citizensense/dustbox/README.md

# Dustbox

A place to hold details of the [particulate matter sensor](http://www.citizensense.net/sensors/particulate-matter-prototype/).

## Contents

 * [Dustbox-BOM.xls](Dustbox-BOM.xls) - Bill of Materials (i.e. parts needed to build a Dustbox)
 * [Dustbox.kicad_mod](Dustbox.kicad_mod) - Custom KiCad footprints used by the board (initially just the Dustbox text)
 * [Dustbox.kicad_pcb](Dustbox.kicad_pcb) - KiCad PCB design file
 * [Dustbox.net](Dustbox.net) - KiCad netlist file
 * [Dustbox.pro](Dustbox.pro) - Main KiCad project file
 * [Dustbox.sch](Dustbox.sch) - KiCad schematic file
 * [README.md](README.md) - this file
