citizensense/dustbox/Dustbox-BOM.xls

Dustbox
Bill of Materials
Part | PCB Label | Quantity | Supplier | Part Number
Electric Imp | n/a | 1
April board | n/a | 1
Shinyei PPD42NS | n/a | 1
Fan | n/a | 1
2-way 2.54mm pitch screw terminal | P3 | 1 | Farnell | 2112482
3-way 2.54mm pitch screw terminal | P2 | 1 | Farnell | 2396254
560 ohm resistor | R1 | 1 | Farnell | 2329690
1k ohm resistor | R2 | 1 | Farnell | 2329626
2-way 2.54mm pitch header | P5 | 1 | Farnell | 3419046
9-way 2.54mm pitch header | P4 | 1
Optional battery power circuit
2-way 2.54mm pitch screw terminal | P1 | 1 | Farnell | 2112482
1N5817 schottkey diode | D1 | 1 | Farnell | 9801197
LF50CV 5V LDO regulator | U1 | 1 | Farnell | 1094240
