citizensense/dustbox/(commit log)

2016-08-26 Add initial version of the PCB.
    [Dustbox.kicad_pcb, Dustbox.sch]
2016-08-26 Add bill of materials for PCB.
    [Dustbox-BOM.xls]
2016-08-26 Revisions after casing size check.
    * Rotate 180 degrees so text is right-side up
    * Clear area at bottom to allow mounting cleanly
    * Add mounting holes
    [Dustbox.kicad_pcb]
2016-08-26 Change Dustbox logo and URL to Franklin Gothic
    [Dustbox.kicad_pcb]
2016-08-30 Add mounting hole for the PM sensor.
    [Dustbox.kicad_pcb]
2016-08-31 Move fan connector to bottom of the PCB, lose www from citizensense.net text
    [Dustbox.kicad_pcb]
2016-09-07 Gerber files for submission to PCB manufacturers.
